joejabbour/mbgw_REVA11/mainbrd3.kicad_pcb

## KiCad design mainbrd3.kicad_pcb (2026-05-21)

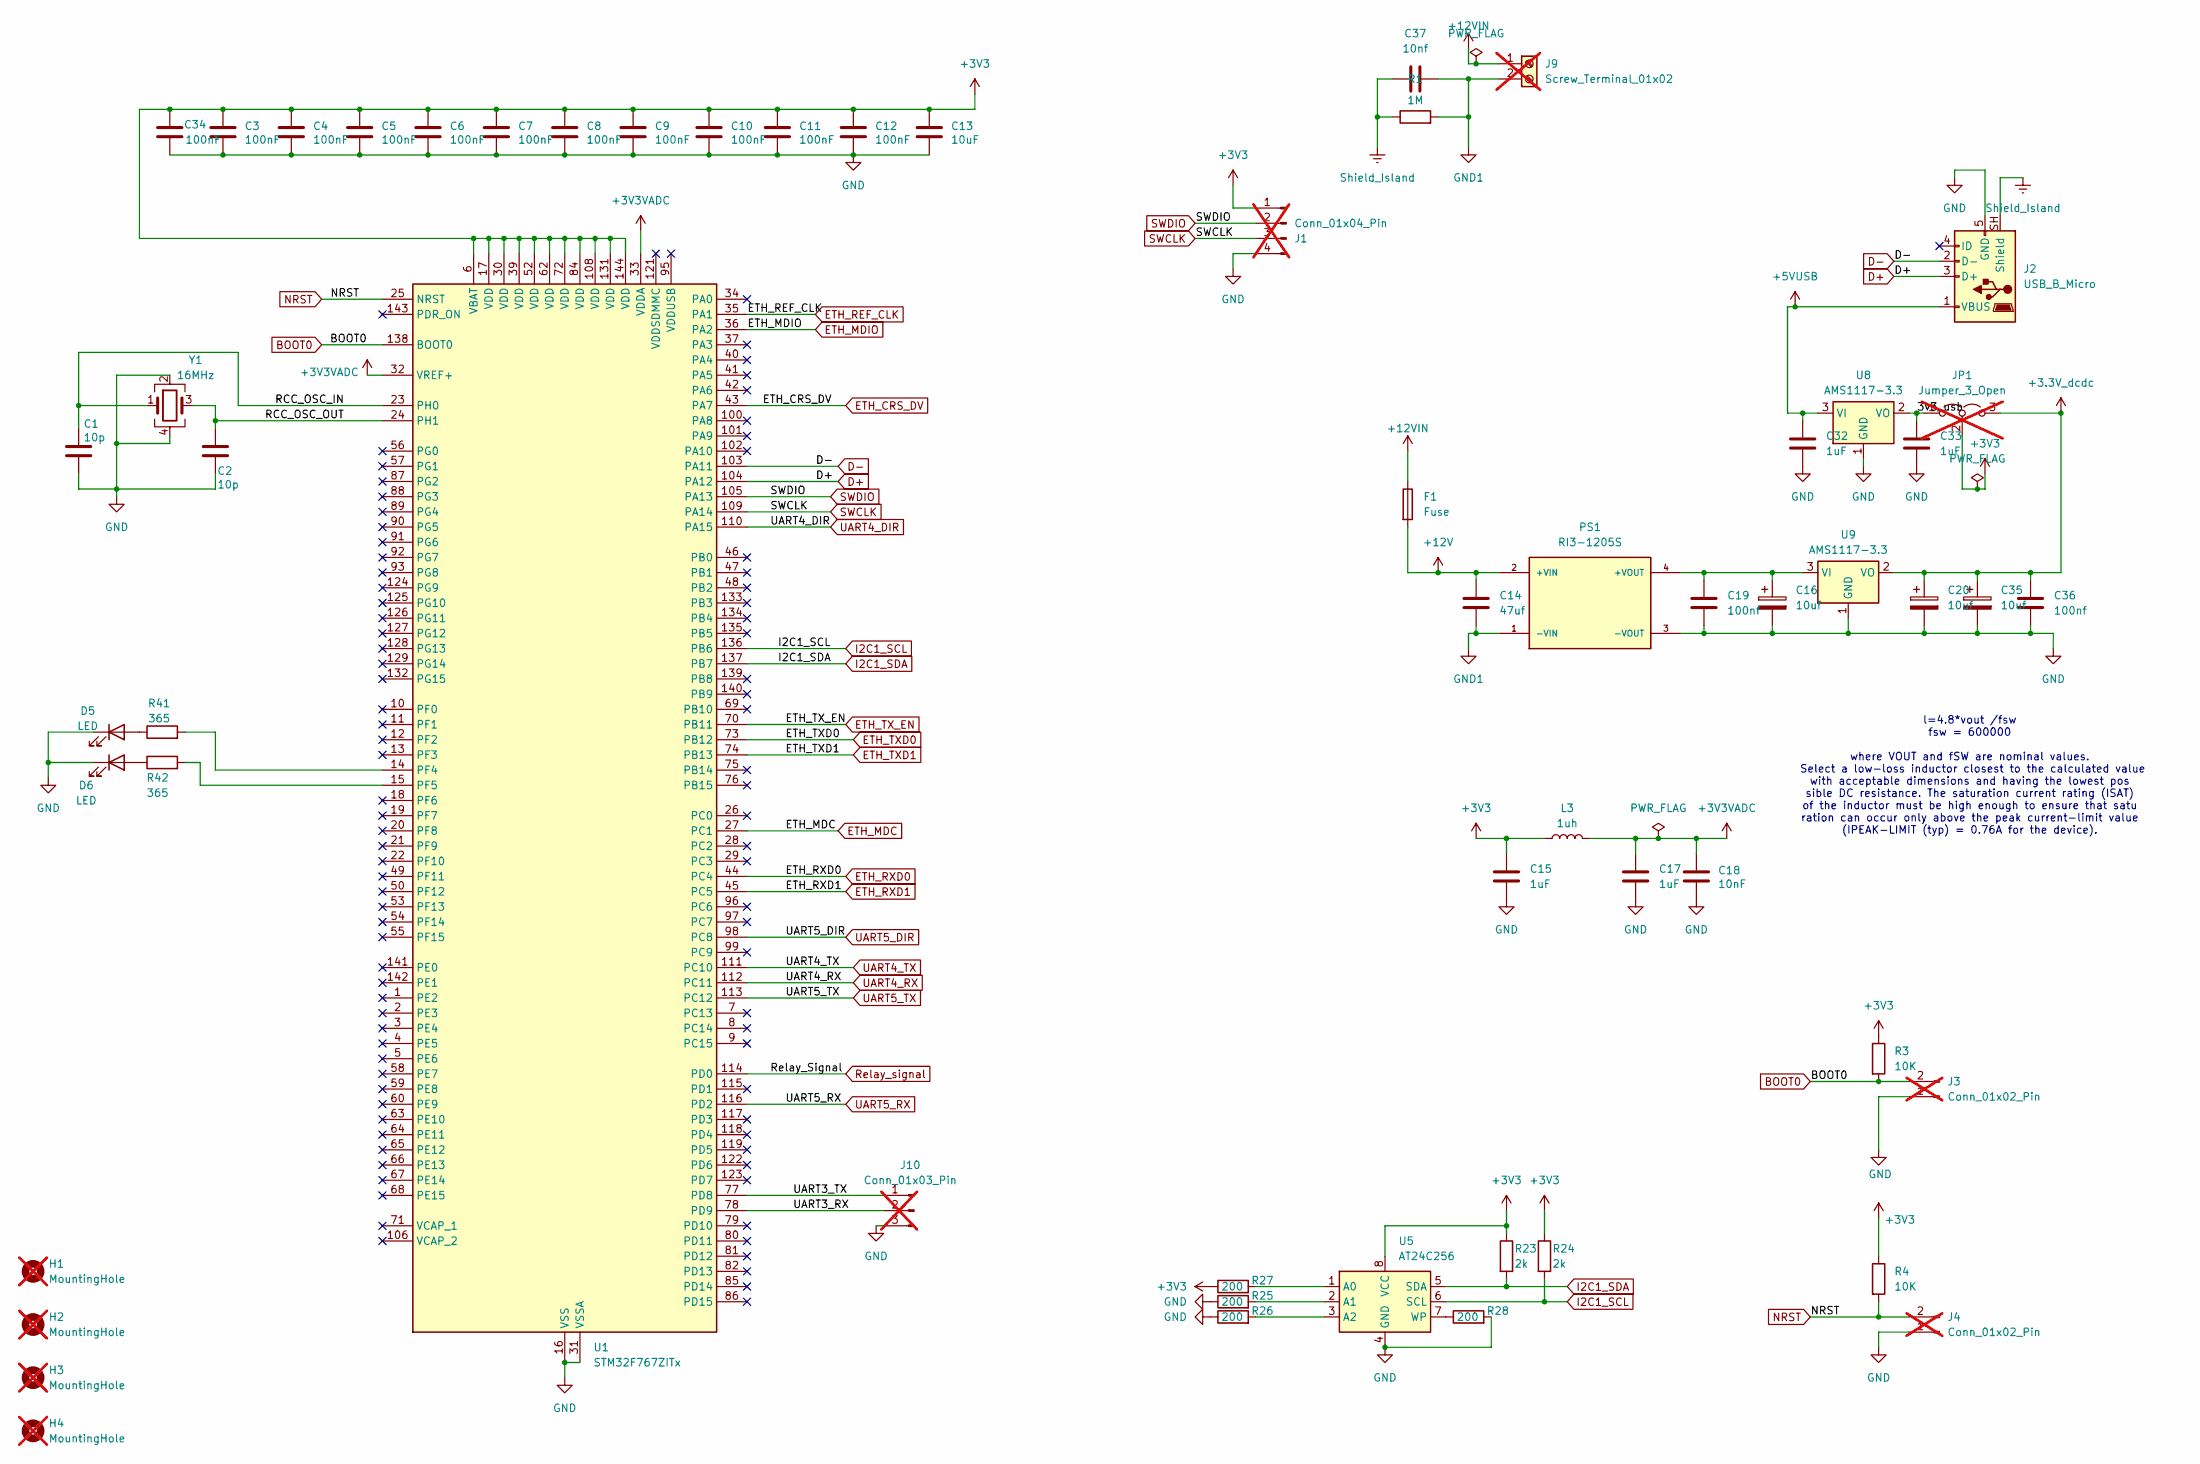
[picture p1: schematic untitled.kicad_sch]

Parts:
C1, C2: 10p; C_0402_1005Metric; MPN 0402CG100J500NT; JLCPCB PN C1545
C3, C4, C5, C6, C7, C8, C9, C10, C11, C12, C34: 100nF; C_0402_1005Metric; MPN 0402F104M500NT; JLCPCB PN C1581
C13: 10uF; C_0603_1608Metric; MPN CL10A106MQ8NNNC; JLCPCB PN C1691
C14: 47uf; C_1210_3225Metric; MPN GRM32ER61C476KE15L; LCSC C77101
C15, C17, C32, C33: 1uF; C_0402_1005Metric; MPN CL05A105KP5NNNC; JLCPCB PN C14445
C16, C20, C35: 10uf; CP_EIA-3216-18_Kemet-A; MPN TAJA106K016RNJ; LCSC C7171
C18: 10nF; C_0402_1005Metric; MPN 0402B103K500NT; JLCPCB PN C1524
C19, C36: 100nf; C_0402_1005Metric; MPN CC0402KRX7R7BB104; LCSC C60474
C37: 10nf; C_1812_4532Metric; MPN 1812B103K202NT; LCSC C574051
D5, D6: LED; LED_0603_1608Metric; MPN KT-0603R; JLCPCB PN C2286
F1: Fuse; Fuse_0603_1608Metric_Pad1.05x0.95mm_HandSolder; MPN 0467001.NRHF; LCSC C151139
H1, H2, H3, H4: MountingHole; MountingHole_2.2mm_M2; not fitted
J1: Conn_01x04_Pin; PinHeader_1x04_P2.54mm_Vertical; not fitted
J2: USB_B_Micro; USB_Micro-B_Wuerth_629105150521; JLCPCB PN 732-5960-2-ND(digi)
J3, J4: Conn_01x02_Pin; PinHeader_1x02_P2.54mm_Vertical; not fitted
J9: Screw_Terminal_01x02; TerminalBlock_Phoenix_MKDS-1,5-2-5.08_1x02_P5.08mm_Horizont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; not fitted
J10: Conn_01x03_Pin; PinHeader_1x03_P2.54mm_Vertical; not fitted
JP1: Jumper_3_Open; SolderJumper-3_P1.3mm_Open_Pad1.0x1.5mm; not fitted
L3: 1uh; L_0805_2012Metric; MPN MCL2012S1R0MT; JLCPCB PN C98325
PS1: RI3-1205S; CONV_RI3-1205S; PARTREV 3
R1: 1M; R_1206_3216Metric; MPN FRC1206J105 TS; LCSC C2907441
R3, R4: 10K; R_0402_1005Metric; MPN 0402WGJ0103TCE; JLCPCB PN C25531
R23, R24: 2k; R_0402_1005Metric; MPN 0402WGF2001TCE; JLCPCB PN C4109
R25, R26, R27, R28: 200; R_0402_1005Metric; MPN 0402WGF2000TCE; JLCPCB PN C25087
R41, R42: 365; R_0402_1005Metric; MPN 0402WGJ0361TCE; JLCPCB PN C25162
U1: STM32F767ZITx; LQFP-144_20x20mm_P0.5mm; MPN STM32F767ZIT6; JLCPCB PN C90235
U5: AT24C256; SOIC-8_3.9x4.9mm_P1.27mm; MPN AT24C256C-SSHL-T; JLCPCB PN C6482
U8, U9: AMS1117-3.3; SOT-223-3_TabPin2; MPN AMS1117-3.3; JLCPCB PN C6186
Y1: 16MHz; Crystal_SMD_3225-4Pin_3.2x2.5mm; MPN WTL3M01610; JLCPCB PN C2857621

Connections:
+3.3V_dcdc: C20.1, C35.1, C36.1, JP1.3 (B), U9.2 (VO)
+3V3: C3.1, C4.1, C5.1, C6.1, C7.1, C8.1, C9.1, C10.1, C11.1, C12.1, C13.1, C15.1, C34.1, J1.1, JP1.2 (C), L3.1, R3.1, R4.1, R23.1, R24.1, R27.1, U1.6 (VBAT), U1.17 (VDD), U1.30 (VDD), U1.39 (VDD), U1.52 (VDD), U1.62 (VDD), U1.72 (VDD), U1.84 (VDD), U1.108 (VDD), U1.131 (VDD), U1.144 (VDD), U5.8 (VCC); also elsewhere on the board
+3V3VADC: C17.1, C18.1, L3.2, U1.32 (VREF+), U1.33 (VDDA)
+5VUSB: C32.1, J2.1 (VBUS), U8.3 (VI)
+12V: C14.1, F1.2, PS1.2 (+VIN); also elsewhere on the board
+12VIN: F1.1, J9.1
/MCU/3v3_usb: C33.1, JP1.1 (A), U8.2 (VO)
/MCU/RCC_OSC_IN: C1.1, U1.23 (PH0), Y1.1
/MCU/RCC_OSC_OUT: C2.1, U1.24 (PH1), Y1.3
/MCU/UART3_RX: J10.2, U1.78 (PD9)
/MCU/UART3_TX: J10.1, U1.77 (PD8)
BOOT0: J3.2, R3.2, U1.138 (BOOT0)
D+: J2.3 (D+), U1.104 (PA12)
D-: J2.2 (D-), U1.103 (PA11)
ETH_CRS_DV: U1.43 (PA7); also elsewhere on the board
ETH_MDC: U1.27 (PC1); also elsewhere on the board
ETH_MDIO: U1.36 (PA2); also elsewhere on the board
ETH_REF_CLK: U1.35 (PA1); also elsewhere on the board
ETH_RXD0: U1.44 (PC4); also elsewhere on the board
ETH_RXD1: U1.45 (PC5); also elsewhere on the board
ETH_TXD0: U1.73 (PB12); also elsewhere on the board
ETH_TXD1: U1.74 (PB13); also elsewhere on the board
ETH_TX_EN: U1.70 (PB11); also elsewhere on the board
GND: C1.2, C2.2, C3.2, C4.2, C5.2, C6.2, C7.2, C8.2, C9.2, C10.2, C11.2, C12.2, C13.2, C15.2, C16.2, C17.2, C18.2, C19.2, C20.2, C32.2, C33.2, C34.2, C35.2, C36.2, D5.1 (K), D6.1 (K), J1.4, J2.5 (GND), J3.1, J4.1, J10.3, PS1.3 (-VOUT), R25.1, R26.1, R28.2, U1.16 (VSS), U1.31 (VSSA), U1.38 (VSS), U1.51 (VSS), U1.61 (VSS), U1.83 (VSS), U1.94 (VSS), U1.107 (VSS), U1.120 (VSS), U1.130 (VSS), U5.4 (GND), U8.1 (GND), U9.1 (GND), Y1.2, Y1.4; also elsewhere on the board
GND1: C14.2, C37.2, J9.2, PS1.1 (-VIN), R1.2; also elsewhere on the board
I2C1_SCL: R24.2, U1.136 (PB6), U5.6 (SCL)
I2C1_SDA: R23.2, U1.137 (PB7), U5.5 (SDA)
NRST: J4.2, R4.2, U1.25 (NRST); also elsewhere on the board
unnamed: D5.2 (A), R41.1
unnamed: D6.2 (A), R42.1
unnamed: C16.1, C19.1, PS1.4 (+VOUT), U9.3 (VI)
unnamed: R41.2, U1.14 (PF4)
unnamed: R42.2, U1.15 (PF5)
unnamed: R27.2, U5.1 (A0)
unnamed: R25.2, U5.2 (A1)
unnamed: R26.2, U5.3 (A2)
unnamed: R28.1, U5.7 (WP)
Relay_signal: U1.114 (PD0); also elsewhere on the board
SWCLK: J1.3, U1.109 (PA14)
SWDIO: J1.2, U1.105 (PA13)
Shield_Island: C37.1, J2.SH (Shield), R1.1; also elsewhere on the board
UART4_DIR: U1.110 (PA15); also elsewhere on the board
UART4_RX: U1.112 (PC11); also elsewhere on the board
UART4_TX: U1.111 (PC10); also elsewhere on the board
UART5_DIR: U1.98 (PC8); also elsewhere on the board
UART5_RX: U1.116 (PD2); also elsewhere on the board
UART5_TX: U1.113 (PC12); also elsewhere on the board

Notes on the sheet:
l=4.8*vout /fsw fsw = 600000 where VOUT and fSW are nominal values. Select a low-loss inductor closest to the calculated value with acceptable dimensions and having the lowest pos sible DC resistance. The saturation current rating (ISAT) of the inductor must be high enough to ensure that satu ratio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

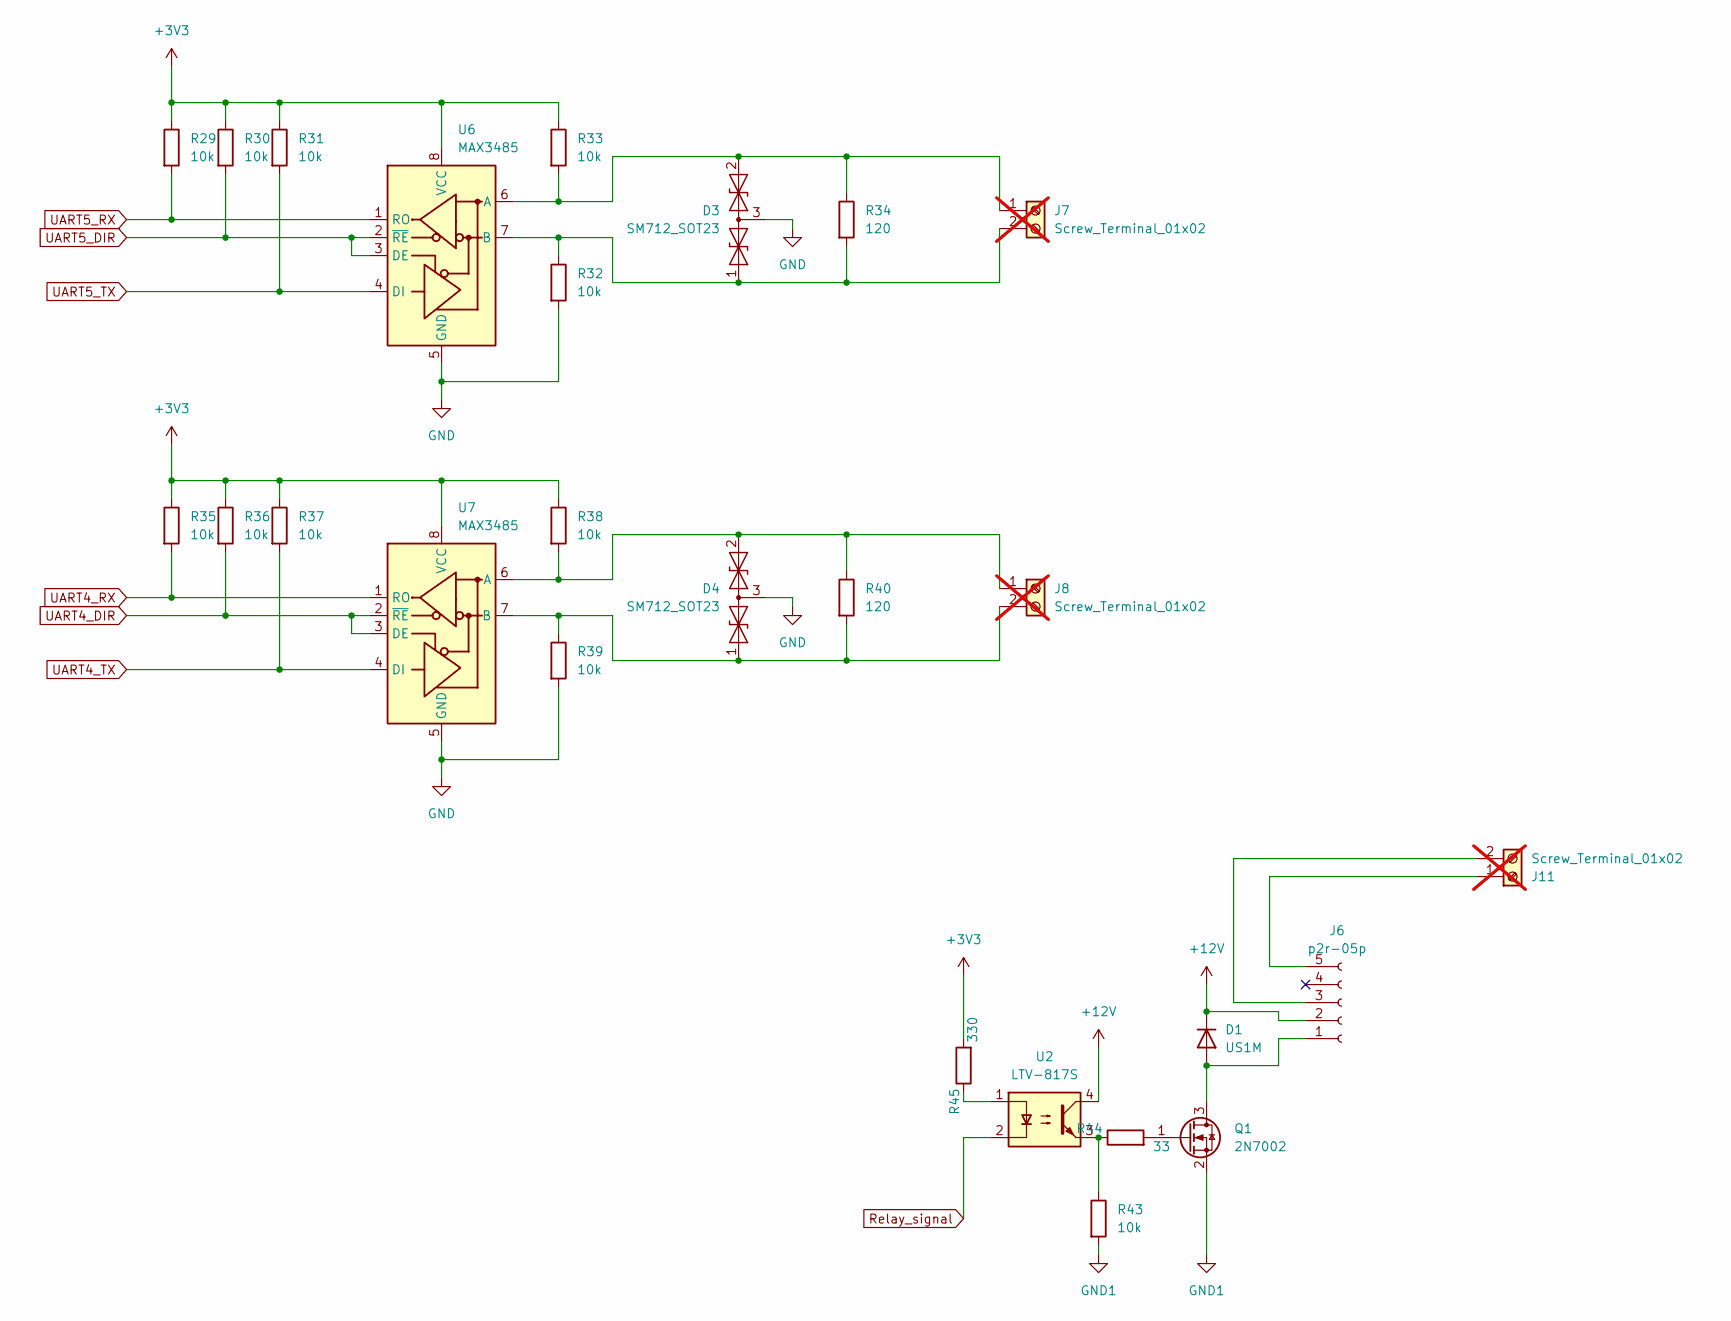
[picture p2: schematic sheet3.kicad_sch]

Parts:
D1: US1M; D_SMA
D3, D4: SM712_SOT23; SOT-23; MPN SM712; JLCPCB PN C293966
J6: p2r-05p; P2R-05P
J7, J8, J11: Screw_Terminal_01x02; TerminalBlock_Phoenix_MKDS-1,5-2-5.08_1x02_P5.08mm_Horizont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; not fitted
Q1: 2N7002; SOT-23; MPN 2N7002; LCSC C916396
R29, R30, R31, R32, R33, R35, R36, R37, R38, R39, R43: 10k; R_0402_1005Metric; MPN 0402WGJ0103TCE; JLCPCB PN C25531
R34, R40: 120; R_0402_1005Metric; MPN 0402WGF1200TCE; JLCPCB PN C25079
R44: 33; R_0402_1005Metric; MPN 0402WGF330JTCE; JLCPCB PN C25105
R45: 330; C_0603_1608Metric; MPN RC0603FR-07330RL; JLCPCB PN C105881
U2: LTV-817S; SMDIP-4_W9.53mm; MPN LTV-817S-TA1-B; LCSC C109227
U6, U7: MAX3485; SOIC-8_3.9x4.9mm_P1.27mm; MPN MAX3485ESA(UMW); JLCPCB PN C668204

Connections:
+3V3: R29.1, R30.1, R31.1, R33.1, R35.1, R36.1, R37.1, R38.1, R45.2, U6.8 (VCC), U7.8 (VCC); also elsewhere on the board
+12V: D1.1 (K), J6.2 (coil_pos), U2.4; also elsewhere on the board
GND: D3.3 (common), D4.3 (common), R32.2, R39.2, U6.5 (GND), U7.5 (GND); also elsewhere on the board
GND1: Q1.2 (S), R43.2; also elsewhere on the board
unnamed: D1.2 (A), J6.1 (coil_neg), Q1.3 (D)
unnamed: D3.1 (A1), J7.2, R32.1, R34.2, U6.7 (B)
unnamed: D3.2 (A2), J7.1, R33.2, R34.1, U6.6 (A)
unnamed: D4.1 (A1), J8.2, R39.1, R40.2, U7.7 (B)
unnamed: D4.2 (A2), J8.1, R38.2, R40.1, U7.6 (A)
unnamed: J6.5 (NO), J11.1
unnamed: J6.3 (Common), J11.2
unnamed: Q1.1 (G), R44.2
unnamed: R43.1, R44.1, U2.3
unnamed: R45.1, U2.1
Relay_signal: U2.2; also elsewhere on the board
UART4_DIR: R36.2, U7.2 (~RE), U7.3 (DE); also elsewhere on the board
UART4_RX: R35.2, U7.1 (RO); also elsewhere on the board
UART4_TX: R37.2, U7.4 (DI); also elsewhere on the board
UART5_DIR: R30.2, U6.2 (~RE), U6.3 (DE); also elsewhere on the board
UART5_RX: R29.2, U6.1 (RO); also elsewhere on the board
UART5_TX: R31.2, U6.4 (DI); also elsewhere on the board

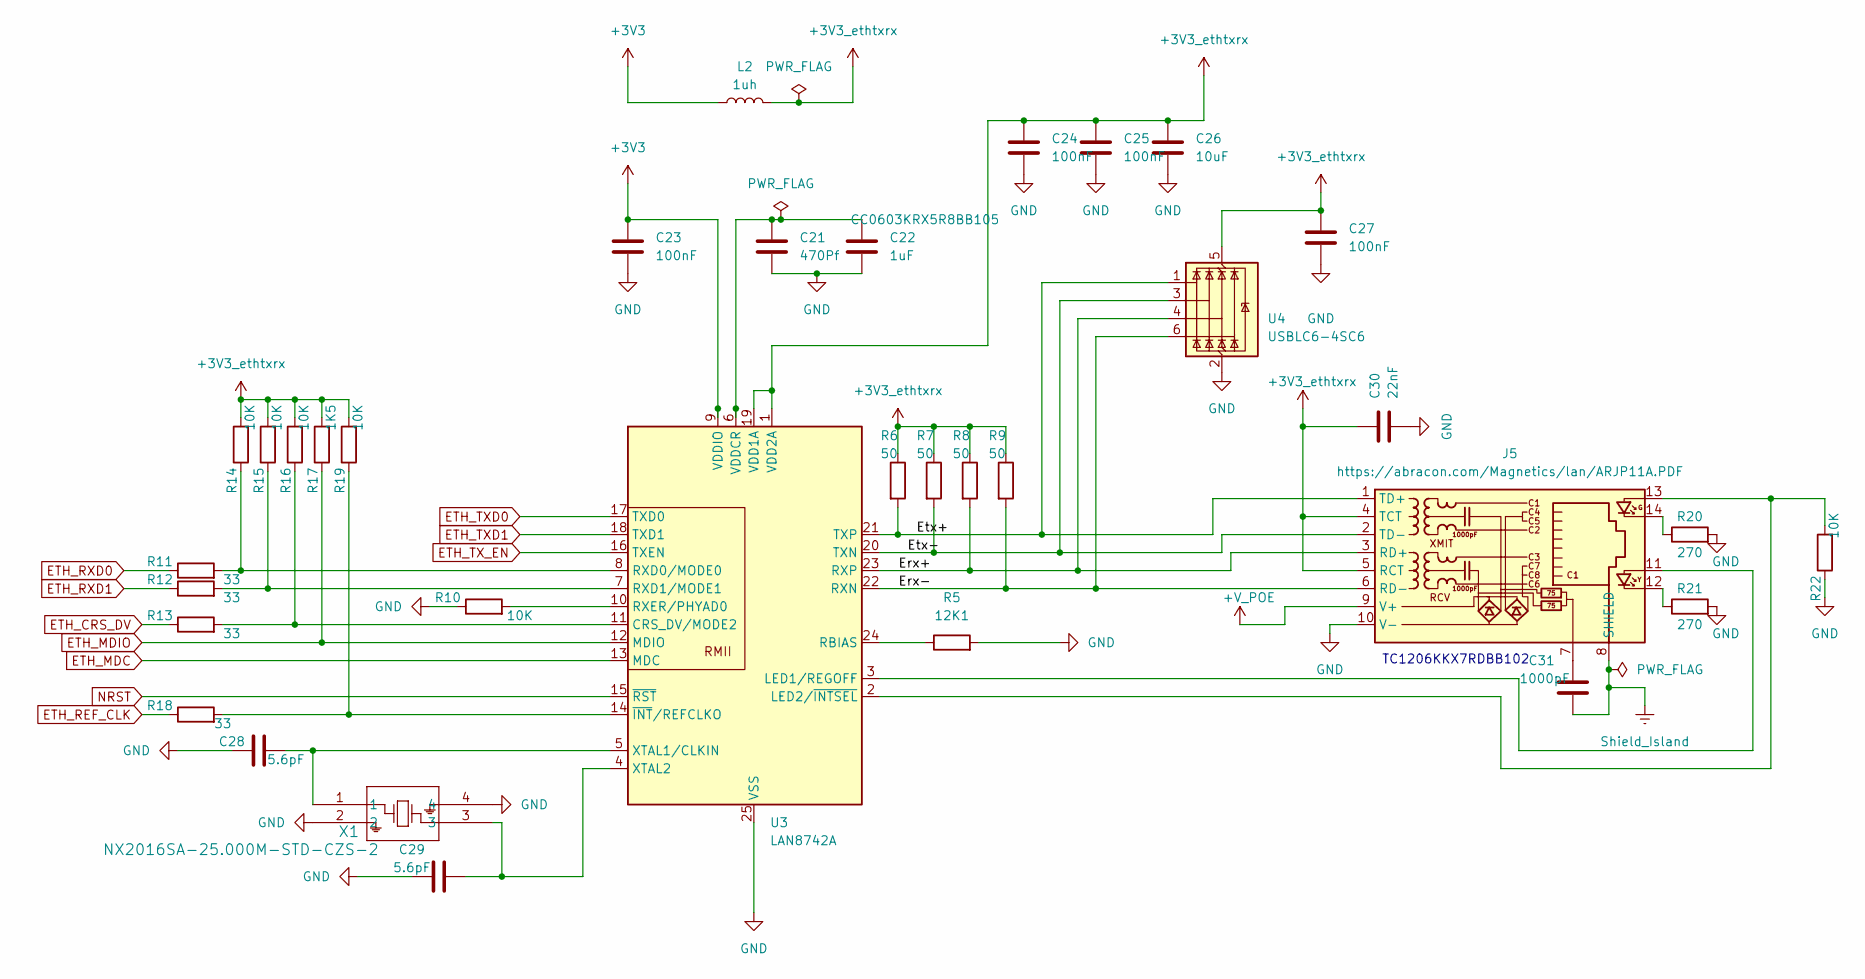
[picture p3: schematic ETH.kicad_sch]

Parts:
C21: 470Pf; C_0402_1005Metric; MPN 0402B471K500NT; JLCPCB PN C1537
C22: 1uF; C_0603_1608Metric; MPN CC0603KRX5R8BB105; JLCPCB PN C14664
C23, C24, C25, C27: 100nF; C_0402_1005Metric; MPN 0402F104M500NT; JLCPCB PN C1581
C26: 10uF; C_0402_1005Metric; MPN CL05A106MQ5NUNC; JLCPCB PN C15525
C28, C29: 5.6pF; C_0402_1005Metric; MPN 0402CG5R6C500NT; JLCPCB PN C1574
C30: 22nF; C_0402_1005Metric; MPN 0402B223K500NT; JLCPCB PN C1532
C31: 1000pF; C_1206_3216Metric; MPN CC1206KKX7RDBB102; JLCPCB PN C23631
J5: https://abracon.com/Magnetics/lan/ARJP11A.PDF; RJ45_Abracon_ARJP11A-MA_Horizontal; JLCPCB PN ARJP11A-MASA-B-A-EMU2-ND(digi)
L2: 1uh; L_0805_2012Metric; MPN MCL2012S1R0MT; JLCPCB PN C98325
R5: 12K1; R_0402_1005Metric; MPN 0402WGF1212TCE; JLCPCB PN C25852
R6, R7, R8, R9: 50; R_0402_1005Metric; MPN AC0402JR-0750RL; JLCPCB PN C227387
R10, R14, R15, R16, R19, R22: 10K; R_0402_1005Metric; MPN 0402WGJ0103TCE; JLCPCB PN C25531
R11, R12, R13, R18: 33; R_0402_1005Metric; MPN 0402WGF330JTCE; JLCPCB PN C25105
R17: 1K5; R_0402_1005Metric; MPN 0402WGF1501TCE; JLCPCB PN C25867
R20, R21: 270; R_0402_1005Metric; MPN RTT022700FTH; JLCPCB PN C11429
U3: LAN8742A; VQFN-24-1EP_4x4mm_P0.5mm_EP2.5x2.5mm_ThermalVias; MPN LAN8742AI-CZ-TR; JLCPCB PN C621425
U4: USBLC6-4SC6; SOT-23-6; JLCPCB PN 497-4492-2-ND(digi)
X1: NX2016SA-25.000M-STD-CZS-2; NX2016SA_NDK; MPN NX2016SA-25MHZ-STD-CZS-2; JLCPCB PN C843258

Connections:
+3V3: C23.1, L2.1, U3.9 (VDDIO); also elsewhere on the board
+3V3_ethtxrx: C24.1, C25.1, C26.1, C27.1, C30.1, J5.4 (TCT), J5.5 (RCT), L2.2, R6.1, R7.1, R8.1, R9.1, R14.2, R15.2, R16.2, R17.2, R19.2, U3.1 (VDD2A), U3.19 (VDD1A), U4.5 (VBUS)
+V_POE: J5.9 (V+)
/ETH/Erx+: J5.3 (RD+), R8.2, U3.23 (RXP), U4.4 (I/O3)
/ETH/Erx-: J5.6 (RD-), R9.2, U3.22 (RXN), U4.6 (I/O4)
/ETH/Etx+: J5.1 (TD+), R6.2, U3.21 (TXP), U4.1 (I/O1)
/ETH/Etx-: J5.2 (TD-), R7.2, U3.20 (TXN), U4.3 (I/O2)
ETH_CRS_DV: R13.1; also elsewhere on the board
ETH_MDC: U3.13 (MDC); also elsewhere on the board
ETH_MDIO: R17.1, U3.12 (MDIO); also elsewhere on the board
ETH_REF_CLK: R18.1; also elsewhere on the board
ETH_RXD0: R11.1; also elsewhere on the board
ETH_RXD1: R12.1; also elsewhere on the board
ETH_TXD0: U3.17 (TXD0); also elsewhere on the board
ETH_TXD1: U3.18 (TXD1); also elsewhere on the board
ETH_TX_EN: U3.16 (TXEN); also elsewhere on the board
GND: C21.2, C22.2, C23.2, C24.2, C25.2, C26.2, C27.2, C28.2, C29.1, C30.2, J5.10 (V-), R5.2, R10.1, R20.2, R21.2, R22.1, U3.25 (VSS), U4.2 (GND), X1.2, X1.4; also elsewhere on the board
NRST: U3.15 (~RST); also elsewhere on the board
unnamed: C31.1, J5.7
unnamed: J5.12, R21.1
unnamed: J5.14, R20.1
unnamed: R13.2, R16.1, U3.11 (CRS_DV/MODE2)
unnamed: J5.11, U3.3 (LED1/REGOFF)
unnamed: J5.13, R22.2, U3.2 (LED2/~INTSEL)
unnamed: R5.1, U3.24 (RBIAS)
unnamed: R11.2, R14.1, U3.8 (RXD0/MODE0)
unnamed: R12.2, R15.1, U3.7 (RXD1/MODE1)
unnamed: R10.2, U3.10 (RXER/PHYAD0)
unnamed: C21.1, C22.1, U3.6 (VDDCR)
unnamed: C28.1, U3.5 (XTAL1/CLKIN), X1.1
unnamed: C29.2, U3.4 (XTAL2), X1.3
unnamed: R18.2, R19.1, U3.14 (~INT/REFCLKO)
Shield_Island: C31.2, J5.8 (SHIELD); also elsewhere on the board

Notes on the sheet:
TC1206KKX7RDBB102

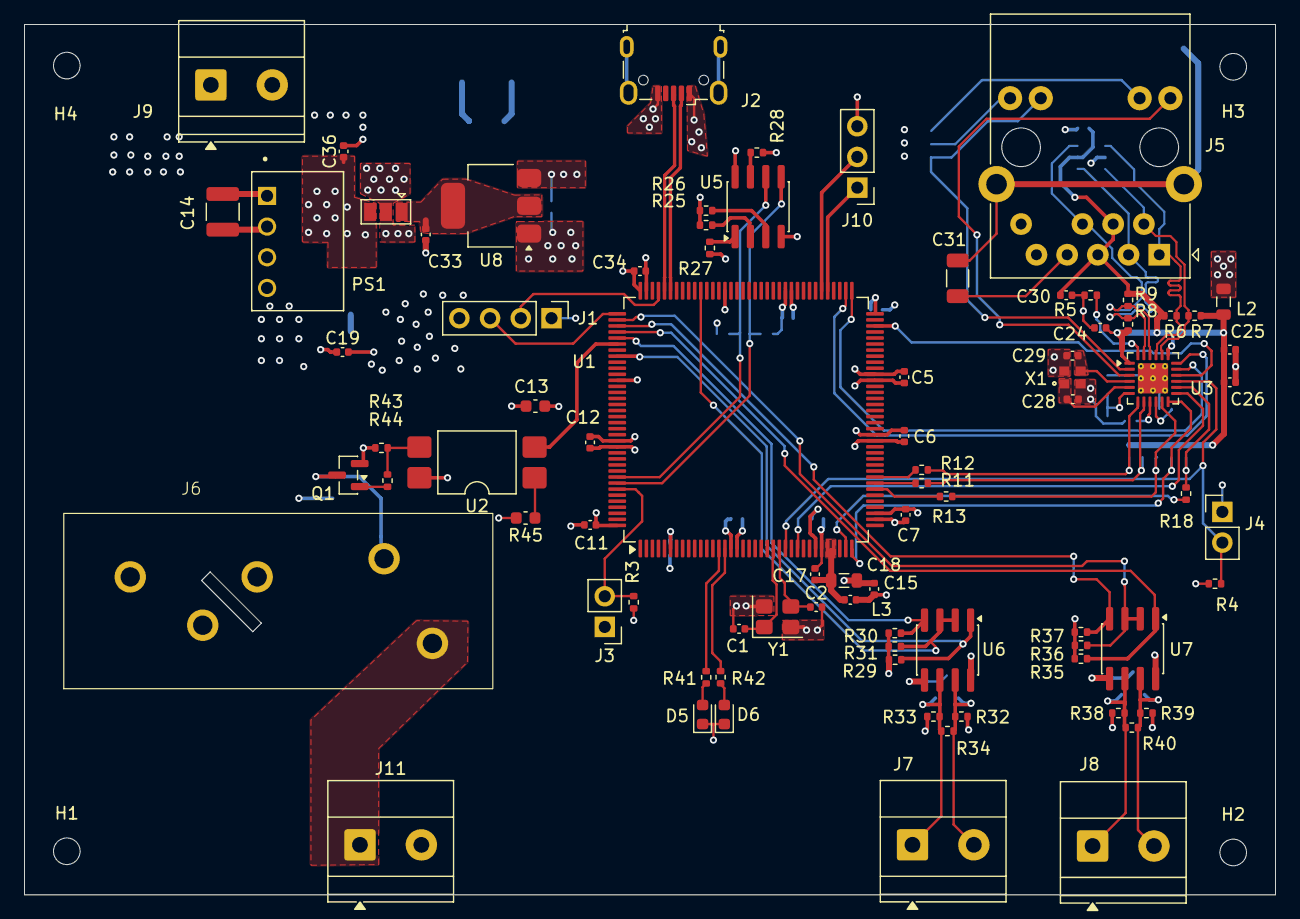
[picture p4: board mainbrd3.kicad_pcb from above]

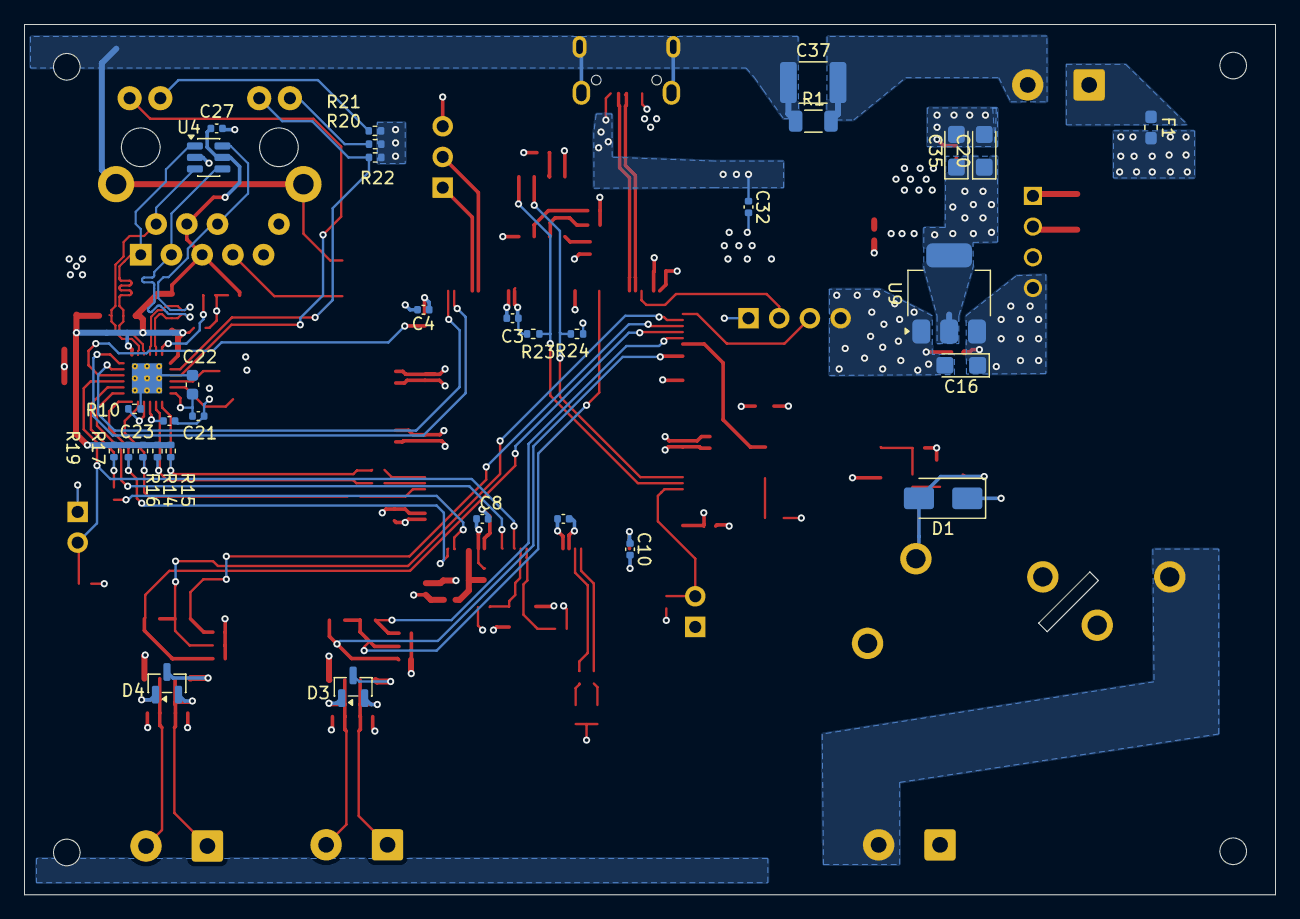
[picture p5: board mainbrd3.kicad_pcb from below]

Board: 4 copper layers, 103.5 x 72.0 mm, 118 parts (32 on the bottom side), 76 nets.
