joejabbour/mbgw_REVA11/(commit log)

2026-04-18 Initial snapshot: 3 files changed mainbrd3.kicad_pcb 2/0/0 mainbrd3.kicad_pro 1/0/0 mainbrd3.kicad_sch 14/0/0
    [mainbrd3.kicad_pcb, mainbrd3.kicad_sch]
2026-04-18 PCB Save: 5 files changed mainbrd3.kicad_pcb 25636/0/2 mainbrd3.kicad_prl 129/0/0 mainbrd3.kicad_pro 693/0/1 ~mainbrd3.kicad_pcb.lck 1/0/0 ~mainbrd3.kicad_sch.lck 1/0/0
    [mainbrd3.kicad_pcb]
2026-04-18 PCB Save: 2 files changed mainbrd3.kicad_pcb 0/0/469 mainbrd3.kicad_prl 0/0/1
    [mainbrd3.kicad_pcb]
2026-04-18 SCH Save: 2 files changed mainbrd3.kicad_pro 6/0/1 mainbrd3.kicad_sch 25/0/9
    [mainbrd3.kicad_sch]
2026-04-18 SCH Save: 1 files changed untitled.kicad_sch 0/10/205
    [untitled.kicad_sch]
2026-04-18 SCH Save: 1 files changed sheet3.kicad_sch 0/0/24
    [sheet3.kicad_sch]
2026-04-18 SCH Save: 1 files changed ETH.kicad_sch 0/0/68
    [ETH.kicad_sch]
2026-04-23 PCB Save: 2 files changed mainbrd3.kicad_pcb 40/0/0 mainbrd3.kicad_pro 17/0/1
    [mainbrd3.kicad_pcb]
2026-04-23 PCB Save: 3 files changed mainbrd3.kicad_pcb 861/0/135 mainbrd3.kicad_prl 13/0/4 ~mainbrd3.kicad_pro.lck 1/0/0
    [mainbrd3.kicad_pcb]
2026-04-23 PCB Save: 2 files changed mainbrd3.kicad_pcb 1188/0/386 mainbrd3.kicad_prl 0/0/2
    [mainbrd3.kicad_pcb]
2026-04-23 PCB Save: 1 files changed mainbrd3.kicad_prl 0/0/2
2026-04-25 PCB Save: 3 files changed mainbrd3.kicad_pcb 748/0/2692 mainbrd3.kicad_prl 0/0/2 mainbrd3.kicad_pro 0/0/1
    [mainbrd3.kicad_pcb]
2026-04-25 PCB Save: 2 files changed mainbrd3.kicad_pcb 79/0/261 mainbrd3.kicad_prl 0/0/2
    [mainbrd3.kicad_pcb]
2026-04-25 PCB Save: 3 files changed mainbrd3.kicad_pcb 0/38/838 mainbrd3.kicad_prl 0/0/2 mainbrd3.kicad_pro 0/0/1
    [mainbrd3.kicad_pcb]
2026-04-26 PCB Save: 3 files changed mainbrd3.kicad_pcb 627/0/725 mainbrd3.kicad_prl 0/0/1 mainbrd3.kicad_pro 0/0/1
    [mainbrd3.kicad_pcb]
2026-04-26 PCB Save: 2 files changed mainbrd3.kicad_pcb 12/0/1718 mainbrd3.kicad_prl 0/0/1
    [mainbrd3.kicad_pcb]
2026-04-26 PCB Save: 1 files changed mainbrd3.kicad_pcb 437/0/814
    [mainbrd3.kicad_pcb]
2026-04-26 PCB Save: 3 files changed mainbrd3.kicad_pcb 3388/0/1892 mainbrd3.kicad_prl 0/0/2 mainbrd3.kicad_pro 0/0/3
    [mainbrd3.kicad_pcb]
2026-05-03 PCB Save: 1 files changed mainbrd3.kicad_pcb 1419/0/1758
    [mainbrd3.kicad_pcb]
2026-05-03 PCB Save: 1 files changed mainbrd3.kicad_pcb 500/0/531
    [mainbrd3.kicad_pcb]
2026-05-03 PCB Save: 2 files changed mainbrd3.kicad_pcb 351/0/833 mainbrd3.kicad_prl 0/0/1
    [mainbrd3.kicad_pcb]
2026-05-04 PCB Save: 2 files changed mainbrd3.kicad_pcb 2103/0/7861 mainbrd3.kicad_prl 0/0/2
    [mainbrd3.kicad_pcb]
2026-05-04 PCB Save: 3 files changed mainbrd3.kicad_prl 0/0/1 REVA1-1.kicad_pcb 37353/0/0 REVA1-1.kicad_pro 717/0/0
    [REVA1-1.kicad_pcb]
2026-05-05 PCB Save: 2 files changed mainbrd3.kicad_pcb 0/1115/2443 mainbrd3.kicad_prl 0/0/1
    [mainbrd3.kicad_pcb]
2026-05-05 PCB Save: 2 files changed mainbrd3.kicad_pcb 55/0/0 mainbrd3.kicad_prl 0/0/1
    [mainbrd3.kicad_pcb]
2026-05-05 PCB Save: 1 files changed mainbrd3.kicad_prl 0/0/1
2026-05-05 PCB Save: 1 files changed mainbrd3.kicad_pcb 0/1609/14497
    [mainbrd3.kicad_pcb]
2026-05-05 PCB Save: 1 files changed mainbrd3.kicad_pcb 884/0/1505
    [mainbrd3.kicad_pcb]
2026-05-05 PCB Save: 1 files changed mainbrd3.kicad_pcb 0/8/243
    [mainbrd3.kicad_pcb]
2026-05-06 SCH Save: 1 files changed untitled.kicad_sch 0/617/2
    [untitled.kicad_sch]
2026-05-06 SCH Save: 1 files changed sheet3.kicad_sch 0/2/12
    [sheet3.kicad_sch]
2026-05-06 PCB Save: 1 files changed mainbrd3.kicad_pcb 1980/0/2540
    [mainbrd3.kicad_pcb]
2026-05-06 PCB Save: 2 files changed mainbrd3.kicad_pcb 402/0/1099 mainbrd3.kicad_prl 0/0/1
    [mainbrd3.kicad_pcb]
2026-05-06 PCB Save: 1 files changed mainbrd3.kicad_pcb 95/0/467
    [mainbrd3.kicad_pcb]
2026-05-06 PCB Save: 1 files changed mainbrd3.kicad_pcb 257/0/873
    [mainbrd3.kicad_pcb]
2026-05-06 PCB Save: 2 files changed mainbrd3.kicad_pcb 679/0/2551 mainbrd3.kicad_prl 0/0/1
    [mainbrd3.kicad_pcb]
2026-05-06 PCB Save: 1 files changed mainbrd3.kicad_pcb 32/0/61
    [mainbrd3.kicad_pcb]
2026-05-06 PCB Save: 3 files changed mainbrd3.kicad_pcb 0/19/2243 mainbrd3.kicad_prl 0/0/1 mainbrd3.kicad_pro 0/0/1
    [mainbrd3.kicad_pcb]
2026-05-07 PCB Save: 2 files changed mainbrd3.kicad_pcb 273/0/2220 mainbrd3.kicad_prl 0/0/2
    [mainbrd3.kicad_pcb]
2026-05-07 PCB Save: 2 files changed mainbrd3.kicad_pcb 0/157/2515 mainbrd3.kicad_prl 0/0/1
    [mainbrd3.kicad_pcb]
2026-05-11 Pre-restore backup: 10 files changed mainbrd3.kicad_prl 143/0/0 mainbrd3.kicad_pro 735/0/0 REVA1-1.kicad_pcb 37353/0/0 REVA1-1.kicad_prl 143/0/0 REVA1-1.kicad_pro 717/0/0 REVA1-2.kicad_pcb 39102/0/0 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
    [REVA1-1.kicad_pcb, REVA1-2.kicad_pcb]
2026-05-11 Restored from 6c1fd55b7c2569fc9f5223d0e45c5a76d0a9d4a9 2026-05-11T21:21:02
    [REVA1-1.kicad_pcb, REVA1-2.kicad_pcb]
2026-05-11 Restored from 084cf424a3c1a4c76f6c3265bbeb2fc9830a544d 2026-05-11T21:32:41
    [REVA1-1.kicad_pcb, REVA1-2.kicad_pcb]
2026-05-19 Pre-restore backup: 6 files changed fp-lib-table 4/0/0 ImportGuides.html 96/0/0 mainbrd3.kicad_prl 0/1/3 mainbrd3.kicad_pro 6/0/3 REVA11.kicad_pcb 39583/0/0 REVA11.kicad_pro 741/0/0
    [REVA11.kicad_pcb]
2026-05-19 Restored from 0e2a30bd2508e00d4570fdbcd08fa9bf24896dcd 2026-05-19T22:47:51
    [REVA11.kicad_pcb]
